gayoung228/Parts-Rental-and-Storage/5조_이진우 이가영_아파트 공구 대여 스마트 관리 시스템.pdf

공구 대여 관리함 | 01

# 아파트 공구대여 스마트 관리 시스템

## 사용자 인증부터 대여·반납 이력까지 관리하는 IoT 시스템

# 이진우 · 이가영

# 프로젝트 기간 : 2026.10.06 - 10.13

목차

공구 대여 관리함 / 발표 순서 | 02
01 프로젝트 소개 | 02 시스템 구성
03 주요 기능 소개 | 04 센서 및 DB 구축
05 실물 및 시연 영상 | 06 한계 및 발전 방향

# 프로젝트 소개

아파트 공구대여 스마트 관리 시스템..

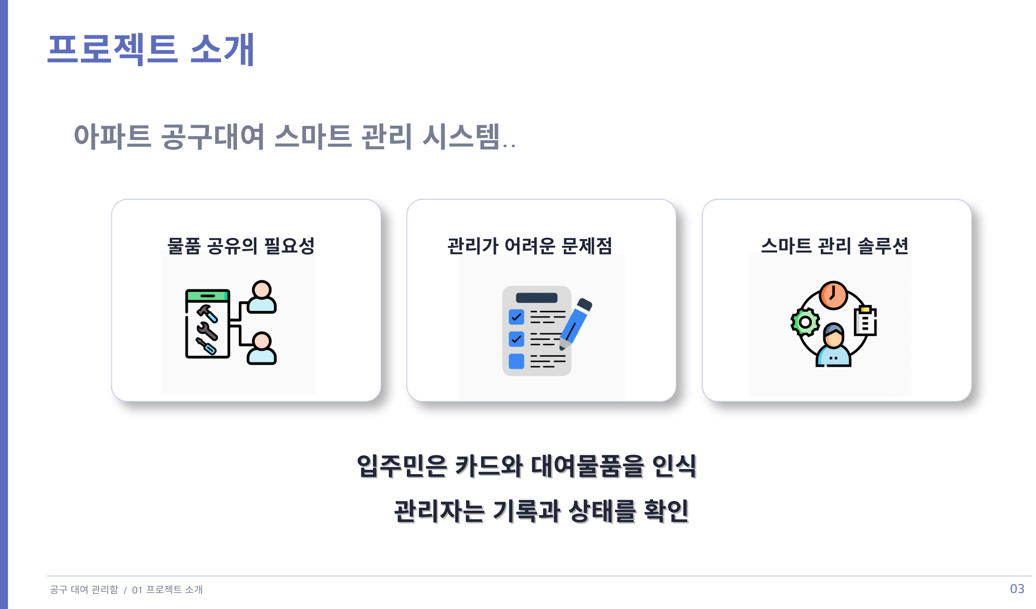
[picture p1: page 3]

공구 대여 관리함 / 01 프로젝트 소개 | 03

# 입주민은 카드와 대여물품을 인식

# 관리자는 기록과 상태를 확인

# 입주민은 카드와 대여물품을 인식

# 관리자는 기록과 상태를 확인

물품 공유의 필요성 | 관리가 어려운 문제점 | 스마트 관리 솔루션

# 시스템 구성도

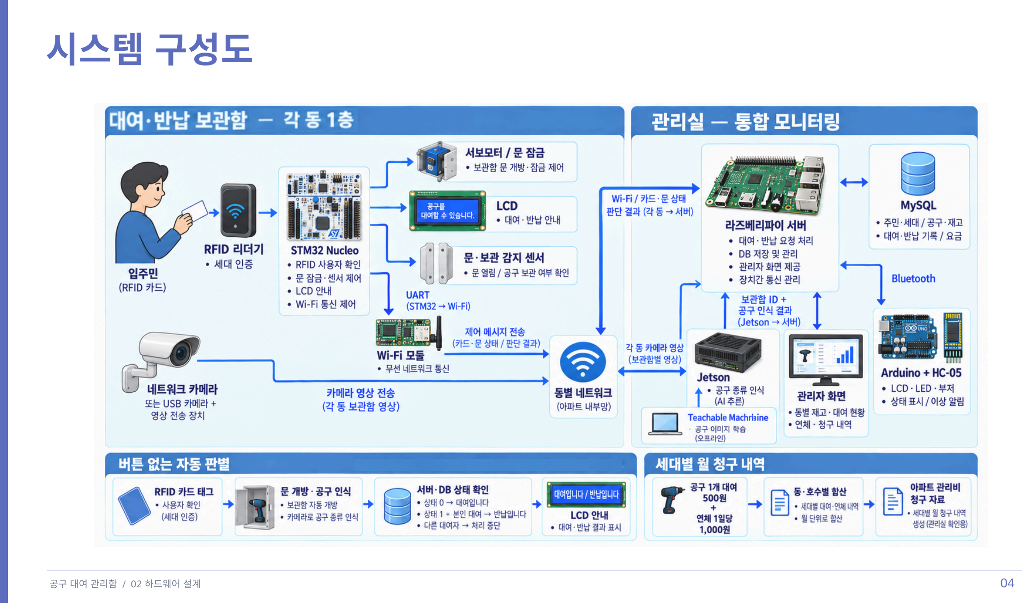
[picture p2: page 4]

공구 대여 관리함 / 02 하드웨어 설계 | 04

# 시스템 구성도

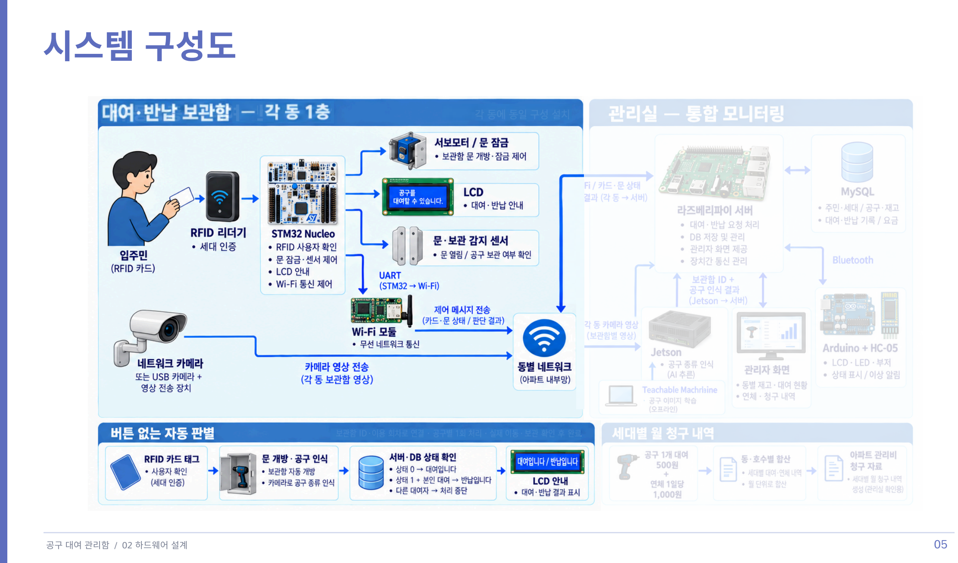
[picture p3: page 5]

공구 대여 관리함 / 02 하드웨어 설계 | 05

# 시스템 구성도

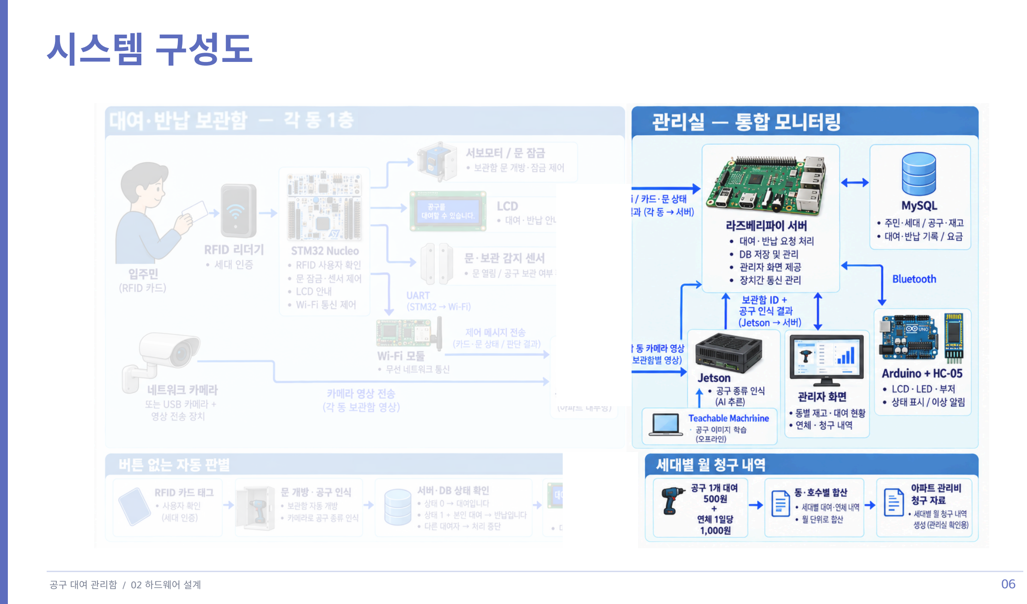
[picture p4: page 6]

공구 대여 관리함 / 02 하드웨어 설계 | 06

# 주요 기능 소개

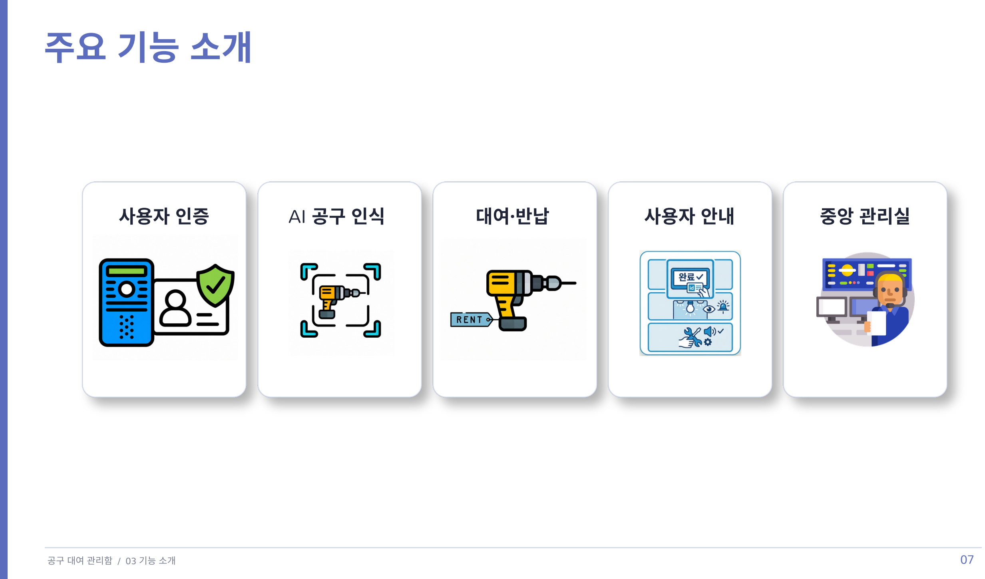
[picture p5: page 7]

공구 대여 관리함 / 03 기능 소개 | 07
사용자 인증 | AI 공구 인식 | 대여·반납 | 사용자 안내 | 중앙 관리실

# 시스템 특징 ① 다중 클라이언트와 서버 간 통신 신뢰성 향상

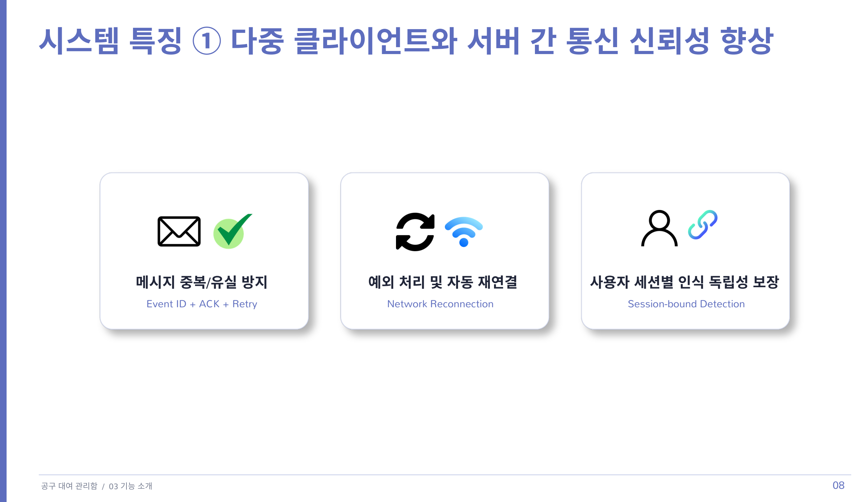
[picture p6: page 8]

# Event ID + ACK + Retry

# 메시지 중복/유실 방지

# Session-bound Detection

# 사용자 세션별 인식 독립성 보장

# Network Reconnection

# 예외 처리 및 자동 재연결

# 시스템 특징 ② 서버의 인증 요청 검증 및 응답 중계 프로세스

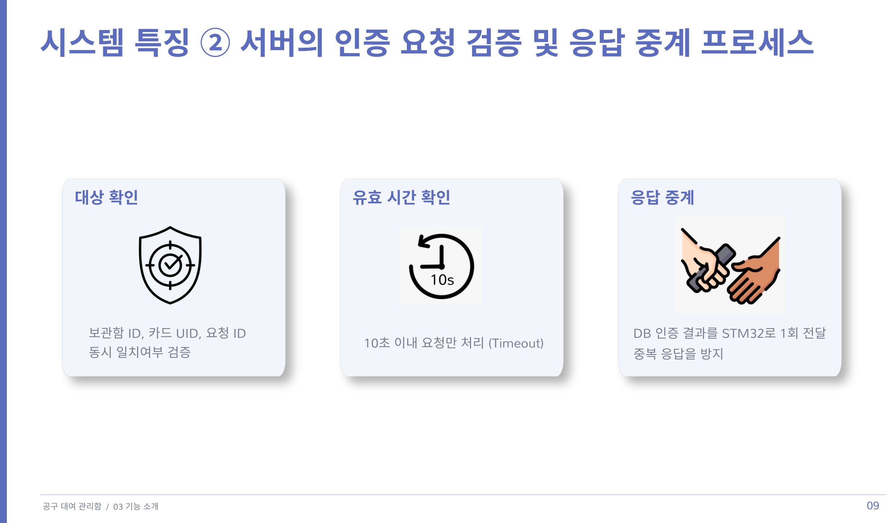
[picture p7: page 9]

# 대상 확인

# 보관함 ID, 카드 UID, 요청 ID

## 동시 일치여부 검증

# 유효 시간 확인

# 10초 이내 요청만 처리 (Timeout)

# 응답 중계

## DB 인증 결과를 STM32로 1회 전달

## 중복 응답을 방지

10s

# AI 물품 인식 성능 평가

# Learning data · 161프레임 / 정답 133 / 오인식 28

82.61%

전체 정확도 : 스트리퍼 | 100.00%

# 27/27 프레임

드라이버 | 100.00%

# 20/20 프레임

니퍼 | 72.97%

# 27/37 프레임

롱노즈 | 72.88%

# 43/59 프레임

멀티미터기 | 88.89%

# 16/18 프레임

## 개선이 필요한 부분

## 니퍼 ↔ 롱노즈 상호 오인식 18건

# 인식 정확도

by

# 트러블 슈팅 ① 물품 중복 인식 문제

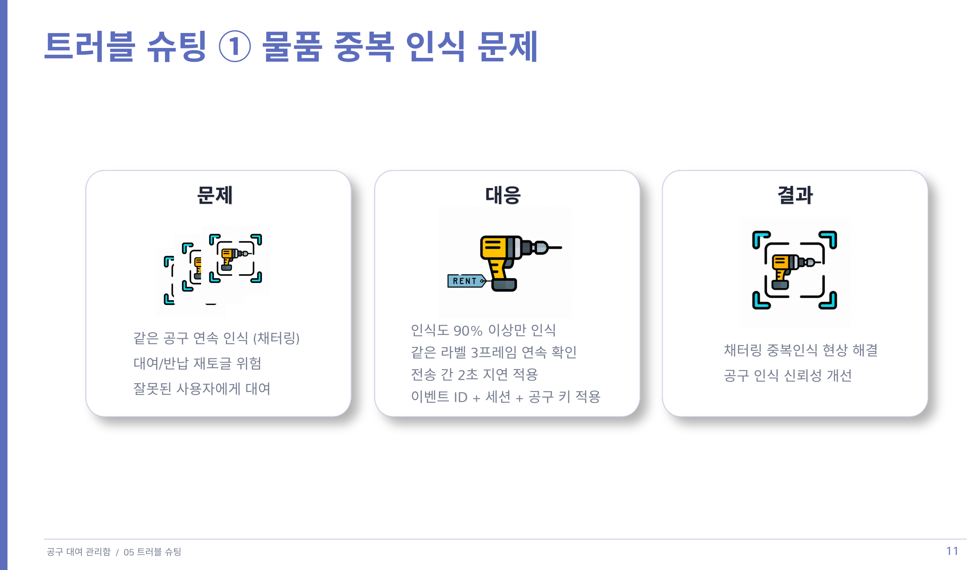
[picture p8: page 11]

공구 대여 관리함 / 05 트러블 슈팅 | 11

문제

## 같은 공구 연속 인식 (채터링)

## 대여/반납 재토글 위험

## 잘못된 사용자에게 대여

## 인식도 90% 이상만 인식 같은 라벨 3프레임 연속 확인 전송 간 2초 지연 적용 이벤트 ID + 세션 + 공구 키 적용

## 채터링 중복인식 현상 해결

## 공구 인식 신뢰성 개선

대응 | 결과

# 센서와 상태의 관계

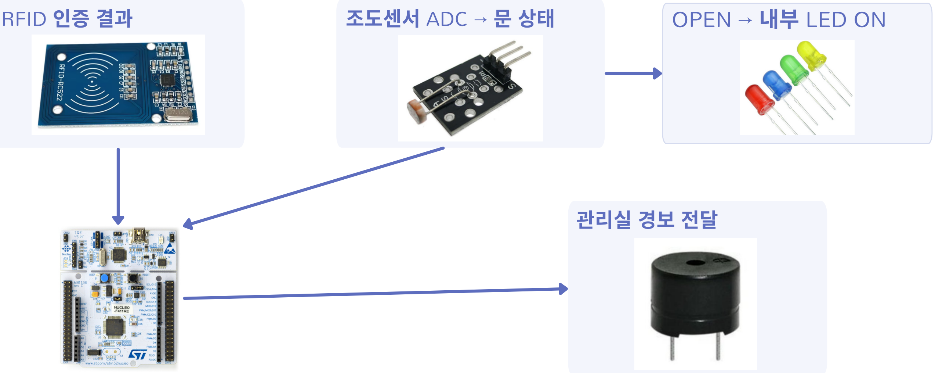
[picture p9: figure]
관리실 경보 전달

RFID 인증 결과 | 조도센서 ADC → 문 상태 | OPEN → 내부 LED ON

# LOCK + OPEN 지속 1초 → BUZZER ACTIVE

# DB 주요 테이블 관계

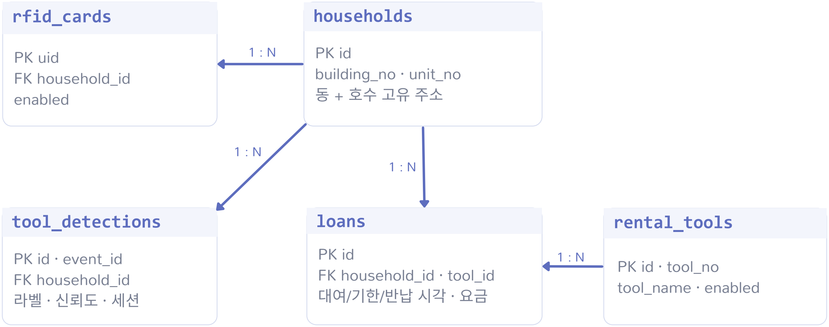
[picture p10: figure]
rfid_cards PK uid FK household_id enabled; households PK id building_no · unit_no 동 + 호수 고유 주소; rental_tools PK id · tool_no tool_name · enabled; tool_detections PK id · event_id FK household_id; 라벨 · 신뢰도 · 세션; loans PK id FK household_id · tool_id 대여/기한/반납 시각 · 요금

# 관리자 웹페이지

# 조회 서버 + HTML/CSS/JavaScript · 5초 자동 갱신

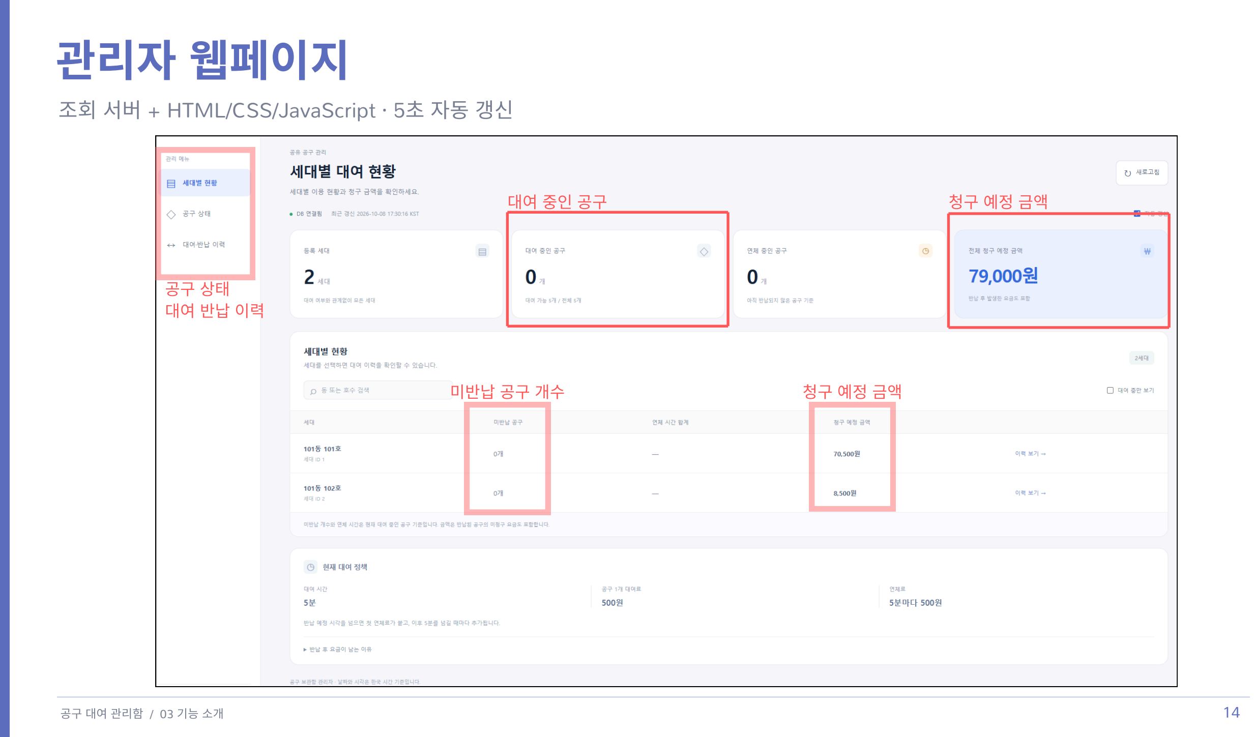
[picture p11: page 14]

미반납 공구 개수 | 청구 예정 금액
대여 중인 공구 | 청구 예정 금액

## 공구 상태 대여 반납 이력

# 무단 개방 경보 로직

# Core/Src/intrusion_alarm.c · intrusion_alarm_update() · 실제 로직 발췌

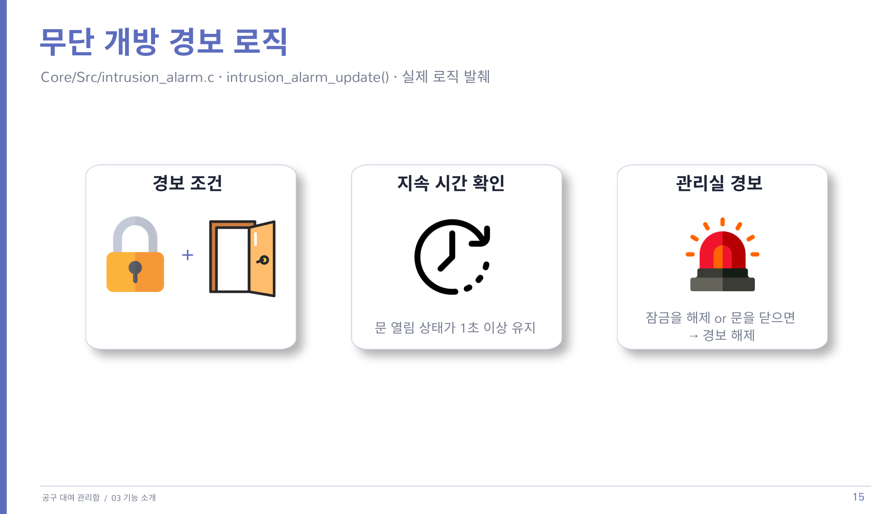
[picture p12: page 15]

## 문 열림 상태가 1초 이상 유지

## 잠금을 해제 or 문을 닫으면 → 경보 해제

# 경보 조건

+

지속 시간 확인 | 관리실 경보

# 트러블 슈팅 ② 블루투스 연결 끊김

# 통신 구간별 로그로 문제 위치를 확인하고 경보 전달을 복구한 사례

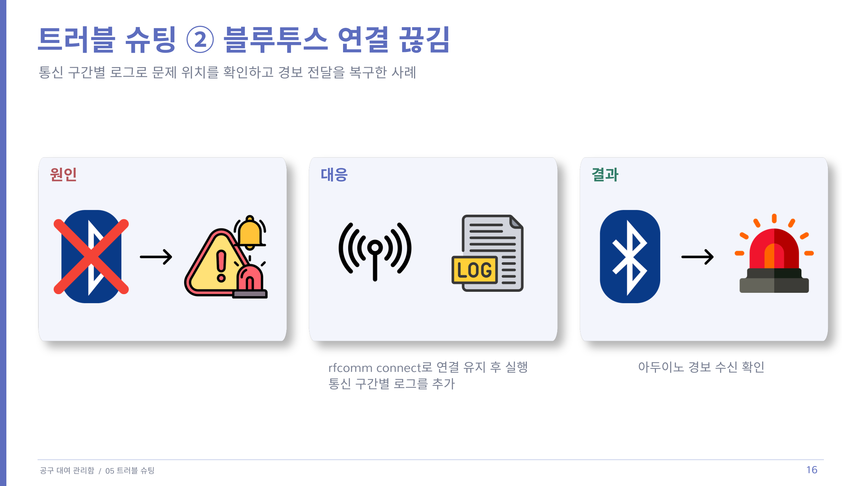
[picture p13: page 16]

공구 대여 관리함 / 05 트러블 슈팅 | 16
원인 | 대응 | 결과

# rfcomm connect로 연결 유지 후 실행

## 통신 구간별 로그를 추가

## 아두이노 경보 수신 확인

# 실물 및 시연 영상

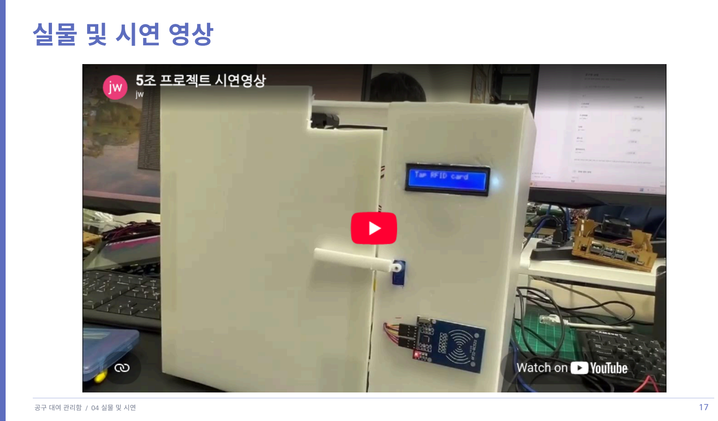
[picture p14: page 17]

공구 대여 관리함 / 04 실물 및 시연 | 17

# 프로젝트 한계 및 개선 방향

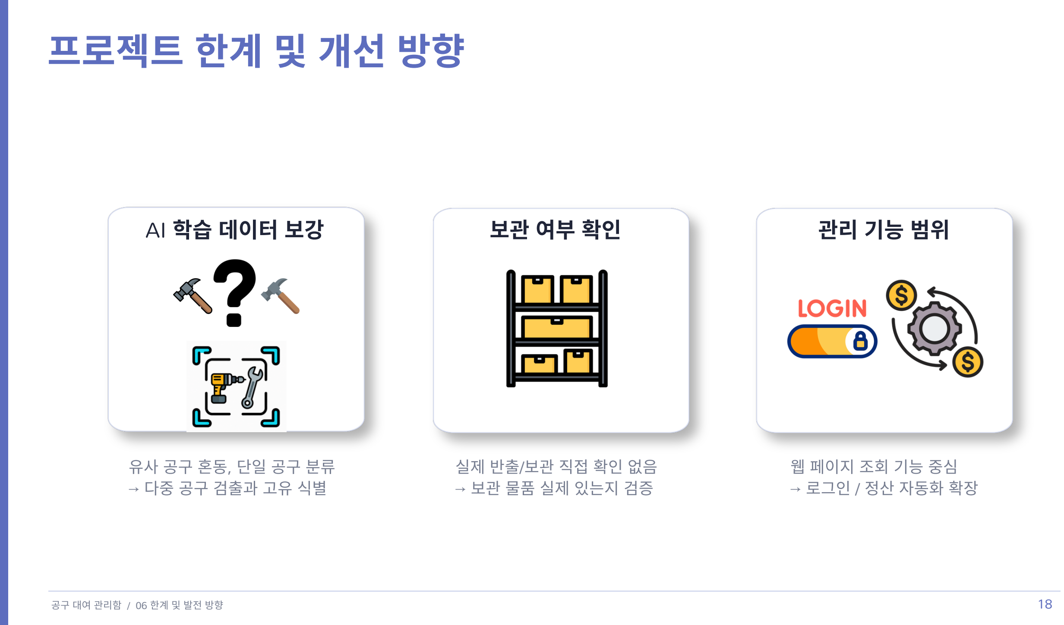
[picture p15: page 18]

공구 대여 관리함 / 06 한계 및 발전 방향 | 18
AI 학습 데이터 보강 | 보관 여부 확인 | 관리 기능 범위

## 유사 공구 혼동, 단일 공구 분류 → 다중 공구 검출과 고유 식별

## 실제 반출/보관 직접 확인 없음 → 보관 물품 실제 있는지 검증

## 웹 페이지 조회 기능 중심 → 로그인 / 정산 자동화 확장

# 역할 분담 & 소감

# 이진우 - AI, TCP, HW, PPT

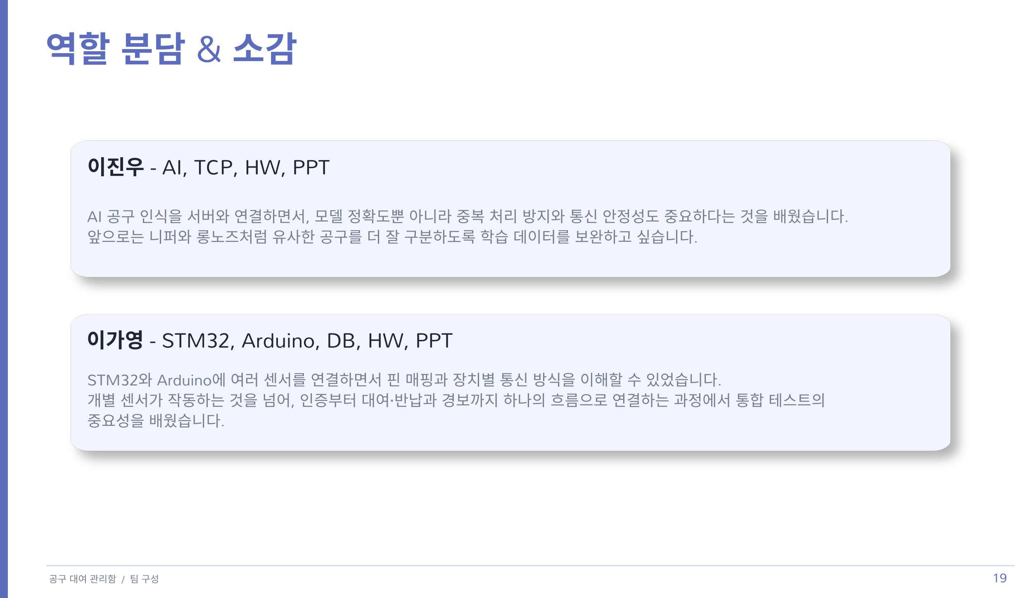
[picture p16: page 19]

공구 대여 관리함 / 팀 구성 | 19

# 이가영 - STM32, Arduino, DB, HW, PPT

AI 공구 인식을 서버와 연결하면서, 모델 정확도뿐 아니라 중복 처리 방지와 통신 안정성도 중요하다는 것을 배웠습니다. 앞으로는 니퍼와 롱노즈처럼 유사한 공구를 더 잘 구분하도록 학습 데이터를 보완하고 싶습니다.

STM32와 Arduino에 여러 센서를 연결하면서 핀 매핑과 장치별 통신 방식을 이해할 수 있었습니다.

## 개별 센서가 작동하는 것을 넘어, 인증부터 대여·반납과 경보까지 하나의 흐름으로 연결하는 과정에서 통합 테스트의

중요성을 배웠습니다.

Q & A

공구 대여 관리함 / 질의응답 | 20

# 감사합니다
