gayoung228/Parts-Rental-and-Storage/Parts-Rental-and-Storage.ioc

Mcu.UserName=STM32F411RETx
PA0-WKUP.Signal=ADCx_IN0
PA13.GPIO_Label=TMS
PA13.Signal=SYS_JTMS-SWDIO
PA14.GPIO_Label=TCK
PA14.Signal=SYS_JTCK-SWCLK
PA2.GPIO_Label=USART_TX
PA2.Signal=USART2_TX
PA3.GPIO_Label=USART_RX
PA3.Signal=USART2_RX
PA5.GPIO_Label=LD2 [Green Led]
PA5.Signal=GPIO_Output
PA8.Signal=S_TIM1_CH1
PB0.Signal=GPIO_Output
PB1.Signal=S_TIM3_CH4
PB12.Signal=GPIO_Output
PB13.Signal=SPI2_SCK
PB14.Signal=SPI2_MISO
PB15.Signal=SPI2_MOSI
PB3.GPIO_Label=SWO
PB3.Signal=SYS_JTDO-SWO
PB8.Signal=I2C1_SCL
PB9.Signal=I2C1_SDA
PC13-ANTI_TAMP.GPIO_Label=B1 [Blue PushButton]
PC13-ANTI_TAMP.Signal=GPXTI13
PC14-OSC32_IN.Signal=RCC_OSC32_IN
PC15-OSC32_OUT.Signal=RCC_OSC32_OUT
PC4.Signal=GPIO_Output
PC6.Signal=USART6_TX
PC7.Signal=USART6_RX
