gayoung228/Parts-Rental-and-Storage/(commit log)

2026-10-06 feature: 핀맵 설정
2026-10-06 fix: STM32 컴파일 설정 연결로 IDE 오류 표시 해결
    [Parts-Rental-and-Storage.ioc]
2026-10-07 feat: 모든 센서 + 웹 페이지 코드_완성
